caua-veiga/Projeto-Integrador/Relatorio/guiaoProjIntegrador.pptx

Guião para a apresentação

- Introduzir o tema
- Overview do sistema final

- Planeamento do projeto
  - Filosofia bottom-up pois não tinhamos a estrutura disponível

- Modulo: Sensor MPU 6050
  - Razões para escolha do modelo
  - Leitura I2C
  - Data fusion: acelerometro + giroscopio, filtro complementar

- Modulo: ESCs e motores sem escovas
  - Especificações do motor
  - Modo de funcionamento da ESC
  - Desvantgem ESP32: Conversão 3.3V->5.0V com OpAmps
  - Queima da ESP32
    - Separar grounds, adicionar 2ª fonte, passer para bidirecional
  - Calibração da ESC

Felipe

Cauã

## Slide 2

  - Algoritmo PID
    - Principio básico de funcionamento
    - Incremental: 1 output para 2 controladores, ±0.5δ
    - Modificações:
      - Limitar termo integral para evitar upwinding
      - Acionar o termo integral apenas perto da posição de equilíbrio

- WiFi
  - Comunicação via socket
  - Fluxograma

Felipe

Cauã

- Video: Demonstração do funcionamento
  - Comentar presença do atrito
  - Comentar efeito do desalinhamento lateral dos motores
