caua-veiga/Projeto-Integrador/APRESENTAÇÃO_v2.pptx

## Controlo PID drone 1-dimensão

Cauã Veiga & Felipe Coutinho

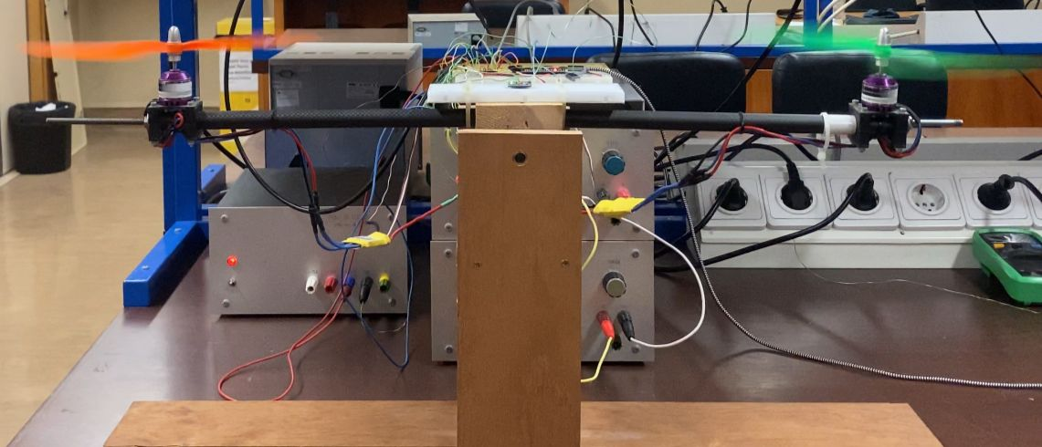
[picture p1: figure]

## Slide 2

Diagrama Circuito Final

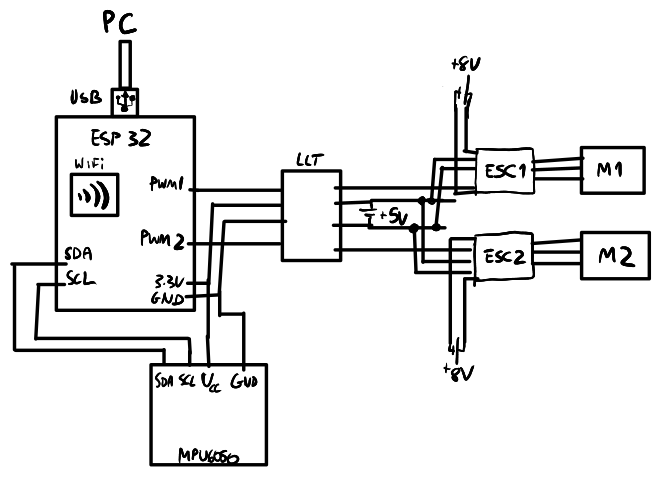
[picture p2: figure]

## Sensor MPU-6050

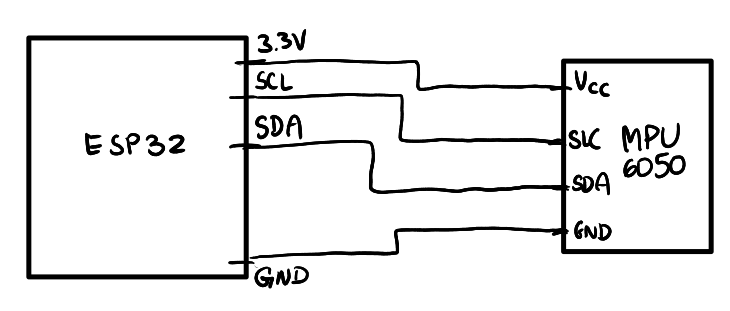
[picture p3: figure]
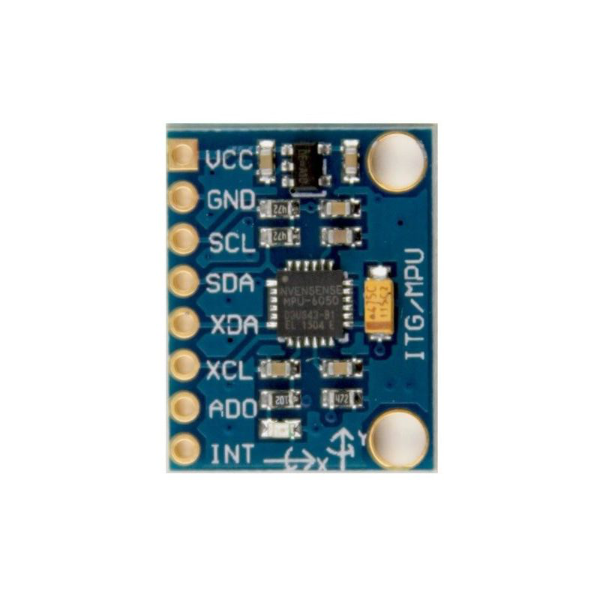
[picture p4: figure]

http://wiki.sunfounder.cc/index.php?title=MPU6050_Module

## Sensor MPU-6050

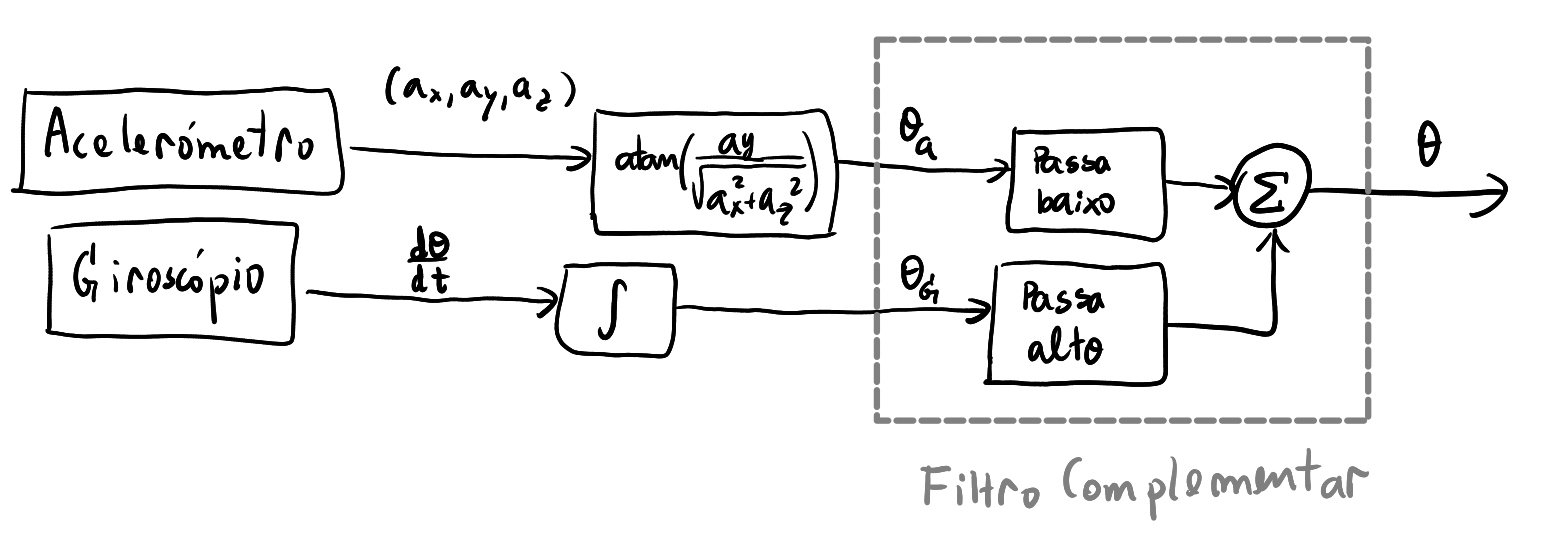
[picture p5: figure]

## Motor Sem Escovas

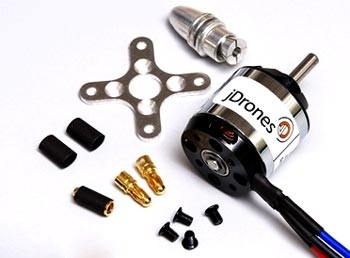
[picture p6: figure]

https://www.buildyourowndrone.co.uk/850kv-motor-ac2830-358

Fonte: 8V
Corrente: 1A

## Slide 6

Electronic Speed Control

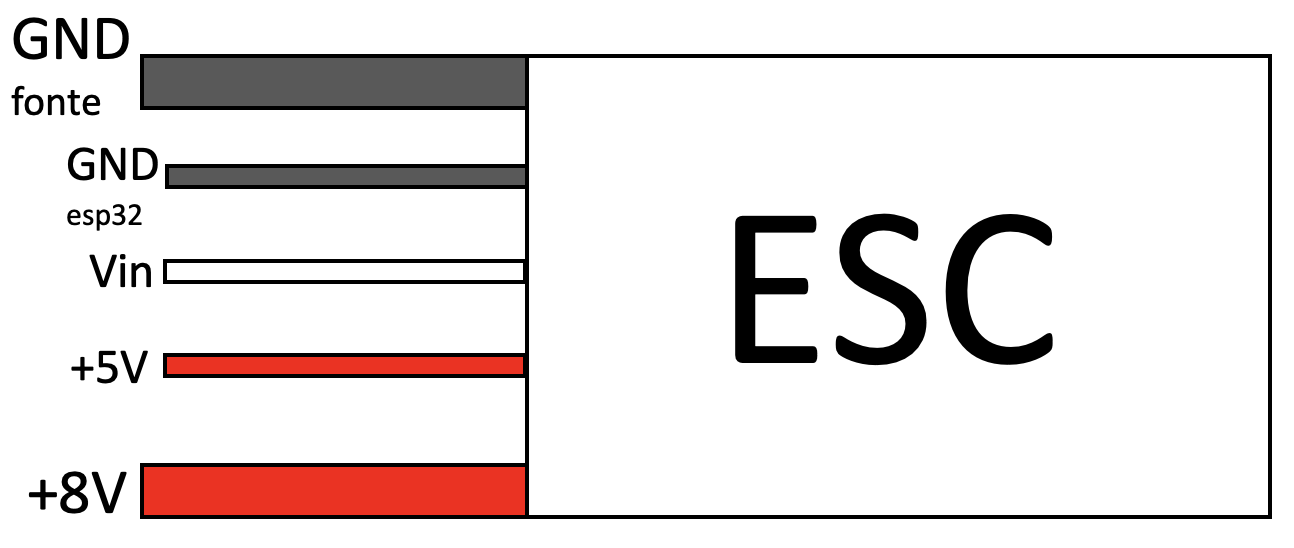
[picture p7: figure]

## Slide 7

Pulse Width Modulation

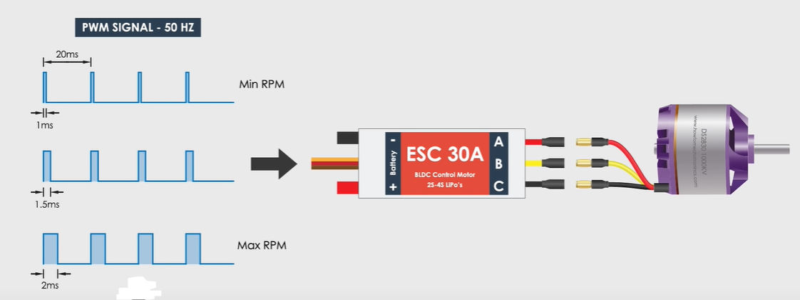
[picture p8: figure]

“How Brushless Motor and ESC Work and How To Control them using Arduino” https://www.youtube.com/watch?v=uOQk8SJso6Q

## Slide 8

Conversão 3.3V -> 5V

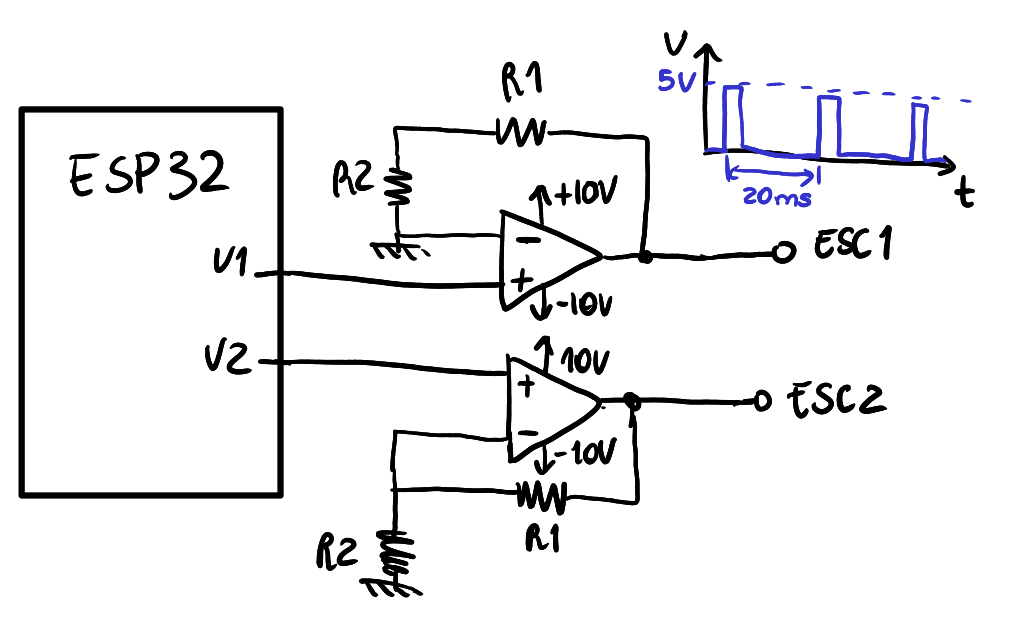
[picture p9: figure]

## Slide 9

Bidirecional 3.3V5V

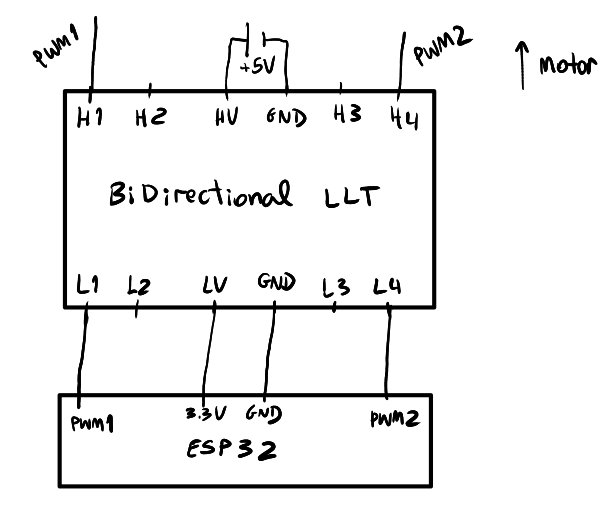
[picture p10: figure]

## Slide 10

Controlador PID

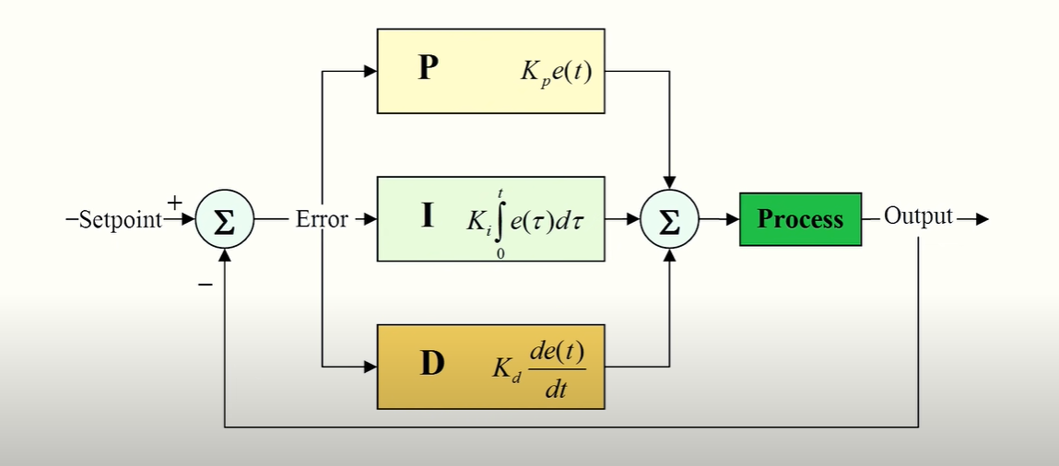
[picture p11: figure]

https://blog.kakaocdn.net/dn/Nk0zF/btqCWdW5LfQ/AUKAtpamO2Ky9Bko9YrWg1/img.png

## Slide 11

Controlador PID

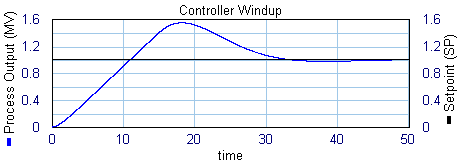
[picture p12: figure]

https://www.20sim.com/webhelp/library_signal_control_pid_control_antiwindup.php

## Slide 12

Comunicação WiFi

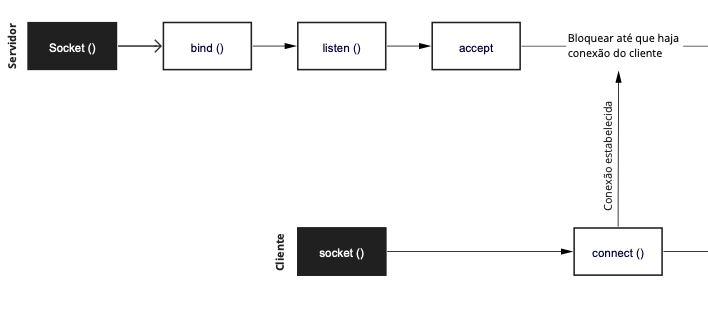
[picture p13: figure]

## Slide 13

Comunicação WiFi

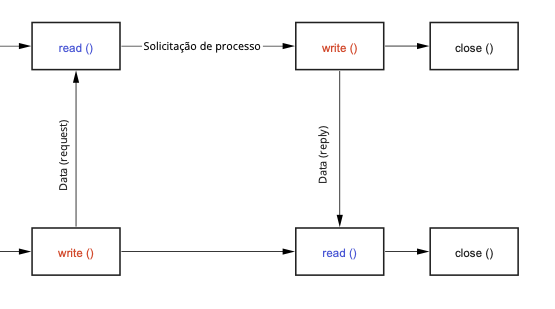
[picture p14: figure]

## Slide 14

Sistema Final

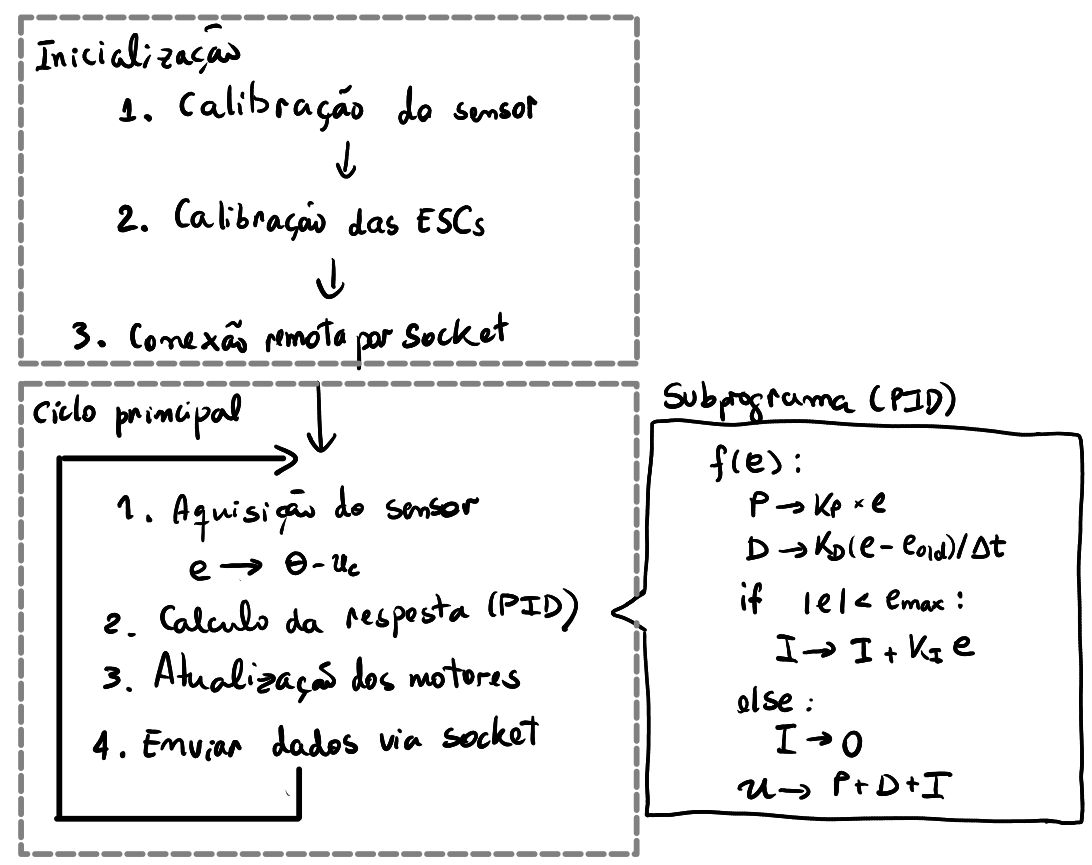
[picture p15: figure]

## Slide 15

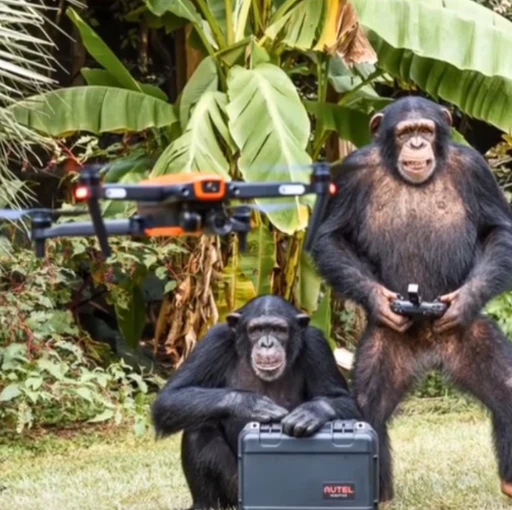
[picture p16: figure]

Demonstração
