caua-veiga/Projeto-Integrador/APRESENTAÇÃO.pptx

## Controlo PID drone 1-dimensão

Cauã Veiga & Felipe Coutinho

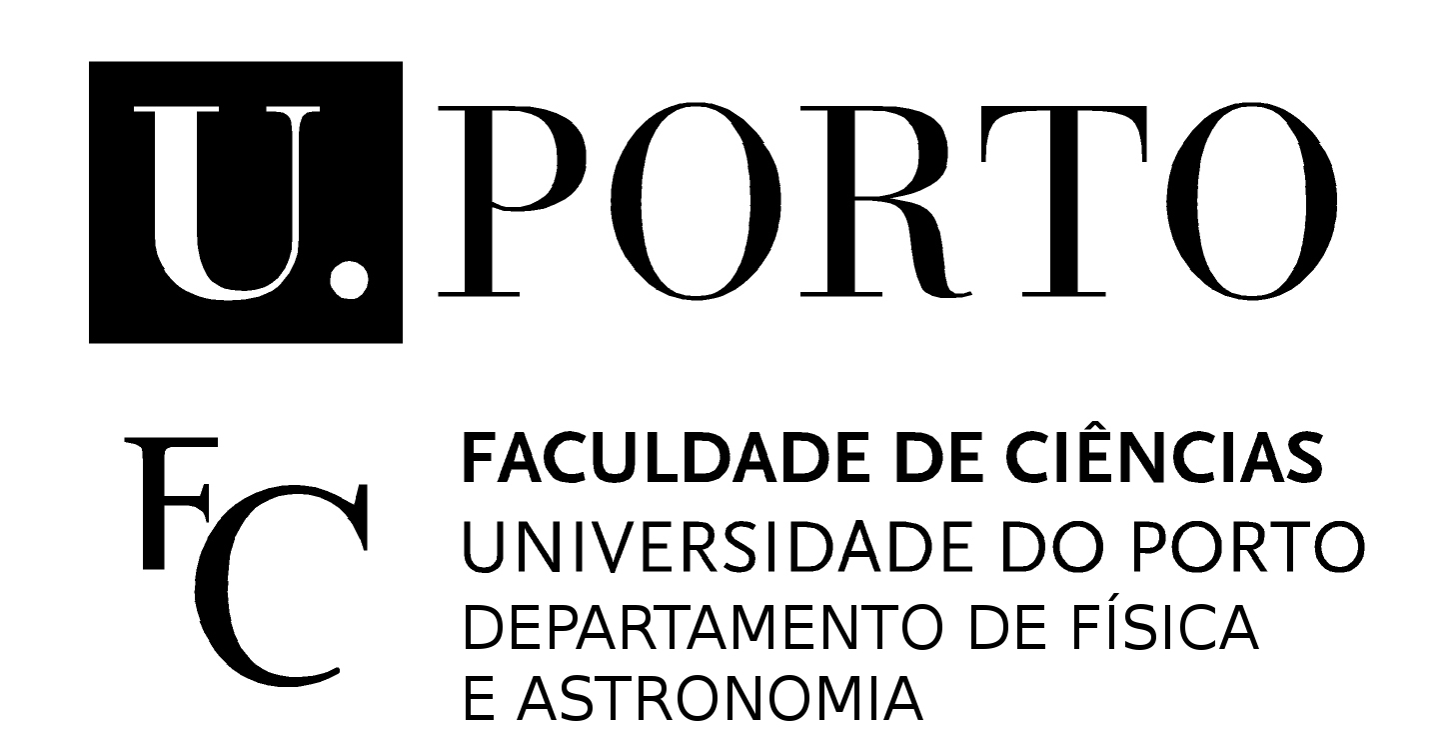
[picture p25: figure]
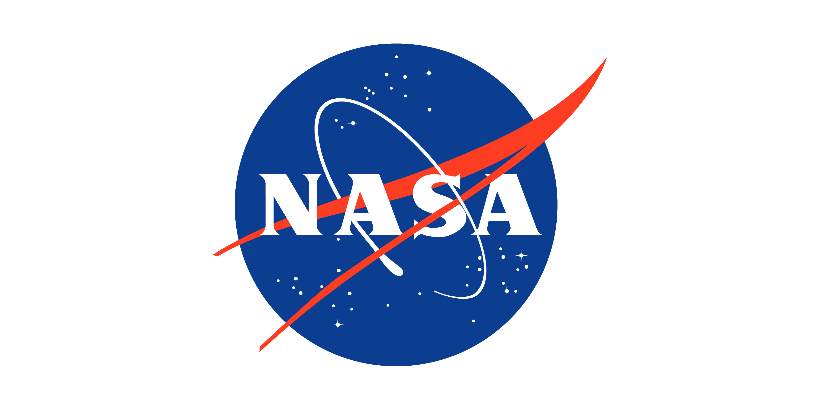
[picture p26: figure]
Symbols of NASA | NASA

## Slide 2

Diagrama Circuito Final


## Sensor MPU-6050


## Sensor MPU-6050


## Motor Sem Escovas


Fonte: 8V
Corrente: 1A

## Slide 6

Electronic Speed Control


## Slide 7

Pulse Width Modulation


## Slide 8

Conversão 3.3V -> 5V


## Slide 9

Bidirecional 3.3V5V


## Slide 10

Controlador PID


## Slide 11

Controlador PID


## Slide 12

Comunicação WiFi


## Slide 13

Comunicação WiFi


## Slide 14

Sistema Final


## Slide 15


Demonstração
