caua-veiga/Projeto-Integrador/Relatorio/imagens/exemplo_leituraSensor.PNG

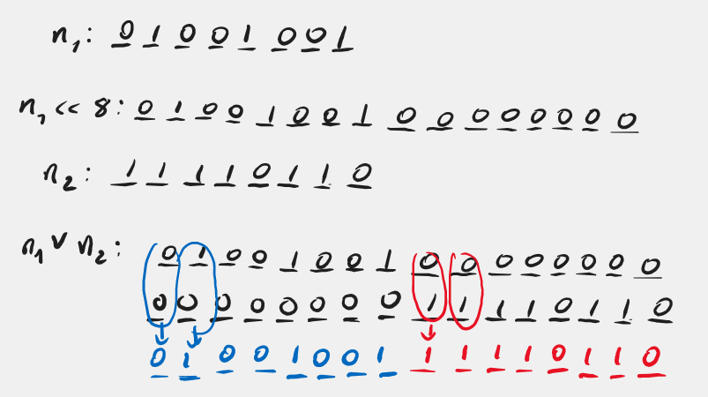
Relatorio/imagens/exemplo_leituraSensor.PNG
