caua-veiga/Projeto-Integrador/Relatorio/imagens/mpu6050_accel_registers.PNG

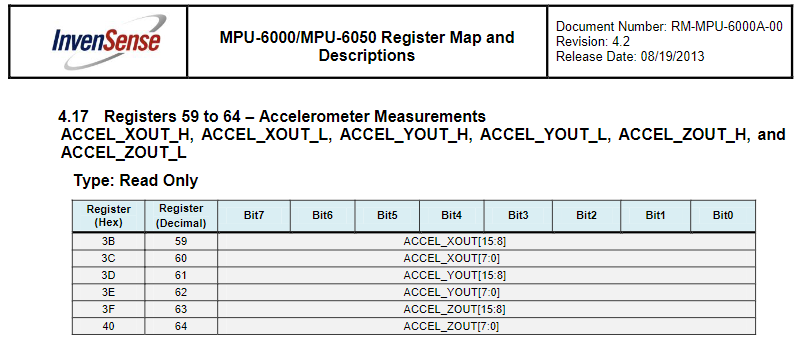
Relatorio/imagens/mpu6050_accel_registers.PNG
