caua-veiga/Projeto-Integrador/Relatorio/imagens/mpu6050_gyro_registers.PNG

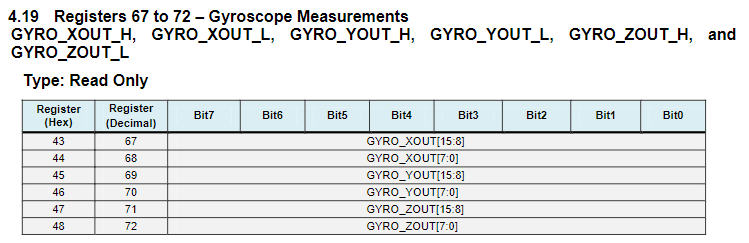
Relatorio/imagens/mpu6050_gyro_registers.PNG
