caua-veiga/Projeto-Integrador/Relatorio/PIDDiagramaDeBlocos.PNG

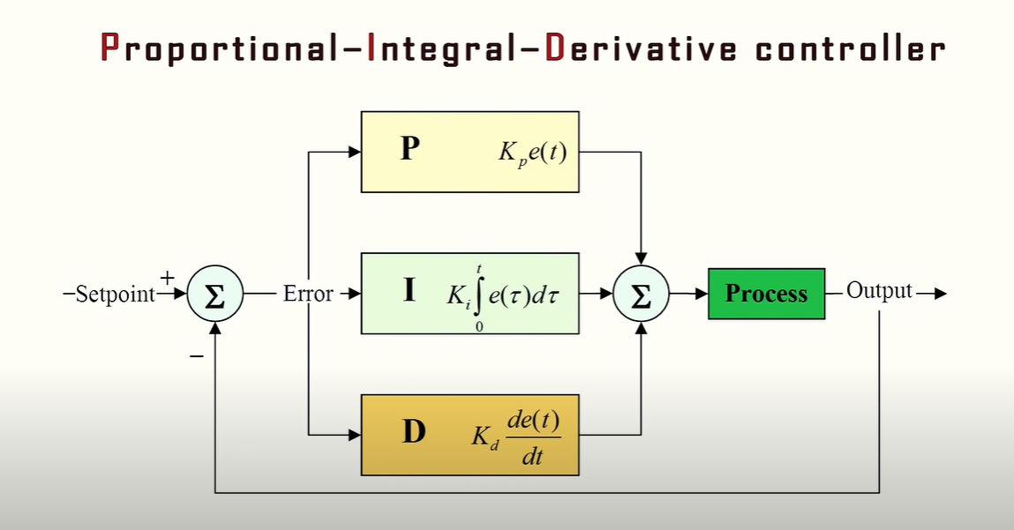
Relatorio/PIDDiagramaDeBlocos.PNG
