caua-veiga/Projeto-Integrador/Relatorio/Wi-Fi.png

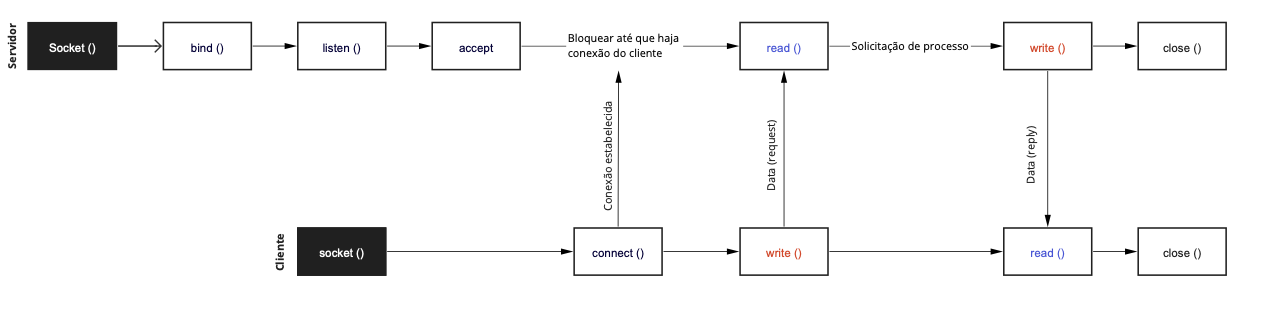
Relatorio/Wi-Fi.png
