caua-veiga/Projeto-Integrador/Logbook/Componentes/comp_motor850Kv.md

https://www.buildyourowndrone.co.uk/850kv-motor-ac2830-358

850Kv Brushless Motor for Multi Rotor QuadCopters, HexaCopters & OctoCopters

This is the ArduCopter multi rotor 850Kv motor which is used by most of the ArduCopter multi rotor developers. It's very reliable and even though it's a smaller motor than its counterpart the 880Kv, it delivers a very good level of thrust with the matched 10x45 propellers.

This 850Kv motor can be bought in a matched and ready to fly kit too, either in a Quadcopter or Hexacopter multi rotor configurations

Motor features:

Size: 28 x 30 mm.

Shaft: 3.17mm.

RPM/V: 850 Kv.

Prop: 10x45.

Battery: 2-4 S LiPo.

Weight: 62gr.

Cables: 35cm / 18 AWG with non soldered bullets.

Tested thrust:

Power out put from ESC, 3S LiPo, 10x45 Propeller:

25%	50%	75%	100%
Amp
Wattage
Thrust	
1 A
11W
170gr

3.4 A
38W
433gr

9 A
100W
855gr

12.2 A
135W
1095gr

Table to get battery voltage
https://blog.ampow.com/lipo-voltage-chart/
