caua-veiga/Projeto-Integrador/Logbook/Componentes/comp_880Kv.md

https://www.buildyourowndrone.co.uk/880kv-motor-ac2836-358

880Kv Brushless Motor for Multi Rotor QuadCopters, HexaCopters & OctoCopters

This is the ArduCopter 880Kv motor which is used for heavier payloads on quadcopters and hexacopter. It's a very reliable motor and is bigger than its counterpart the 850Kv, it delivers a very high level of thrust with the matched 12x45 propellers.  

This 880Kv motor can be bought in a matched and ready to fly kit too, either in a Quadcopter or Hexacopter configurations

This motor is designed for 12x45 Propellers.

Motor features:

Size: 28 x 36 mm.

Shaft: 4mm.

RPM/V: 880 Kv.

Prop: 12x45.

Battery: 2-4 S LiPo.

Weight: 72gr.

Cables: 35cm/18 AWG with bullets (non soldered).

Tested thrust:

Power out put from ESC, 3S LiPo, 12x45 Propeller:

25%

50%

75%

100%

Amp
Wattage
Thrust

1.5 A
17.5W
230gr

6.1 A
70W
650gr

14.2 A
160W
1290gr

20A A
210W
1380gr
