caua-veiga/Projeto-Integrador/Logbook/Componentes/jdrones_wayback.md

https://web.archive.org/web/20110924103158/http://store.jdrones.com/product_p/achxkit1.htm
