caua-veiga/Projeto-Integrador/Logbook/References/Sensor/sourceCode_mpu6050_autocalibration.md

Este código implementa uma rotina de autocalibração para o MPU6050 para Arduino

Para perceber melhor, convém ver o paper sobre isso no diretório References

https://wired.chillibasket.com/2015/01/calibrating-mpu6050/
