caua-veiga/Projeto-Integrador/Logbook/References/References.md

Drone-Deep-Reinforcement-Learning - https://github.com/Kazimbalti/Drone-Deep-Reinforcement-Learning-

Python library for servos - https://docs.micropython.org/en/latest/library/pyb.html
