caua-veiga/Projeto-Integrador/Logbook/ESP32_temp/ESP32.md

# RASCUNHO GUARDAR LINKS    

Podemos ver as placas suportadas pelo tensorflow lite em:
https://www.tensorflow.org/lite/microcontrollers

Talvez fosse boa ideia pedir ao professor um ESP32 pois já teremos experiência de EDM e sabemos que suporta python fácilmente. 

Para além disso, o IMU MPU-6050: https://invensense.tdk.com/products/motion-tracking/6-axis/mpu-6050/

é também fácilmente suportado pelo ESP32: https://randomnerdtutorials.com/esp32-mpu-6050-accelerometer-gyroscope-arduino/

Exemplo de tensorflow lite no esp32: https://blog.tensorflow.org/2020/08/announcing-tensorflow-lite-micro-esp32.html

### Deep Reinforcement Learning on ESP32
https://www.hackster.io/aslamahrahiman/deep-reinforcement-learning-on-esp32-843928

https://github.com/aslamahrahman/Policy-Gradient-Network-Arduino
