caua-veiga/Projeto-Integrador/Logbook/Week_Progress/Week1.md

# Done

In the first week as a prepation we planned the main scope of our project. During the class we occupied ourselves by identifying the material given to us, we gathered some documentation about the components (Componentes directory) and properly disassembled the drone so that we can continue our work next week. 

## 1. Identified Components
1. 850Kv Brushless Motor - https://www.buildyourowndrone.co.uk/850kv-motor-ac2830-358

2. jDrones 20 Amp ESC AC20-1.0 - https://www.buildyourowndrone.co.uk/arducopter-esc-20-amp
