caua-veiga/Projeto-Integrador/Logbook/References/Sensor/sourceCode_mpu6050light_arduino.md

Link para o source code do pacote MPU6050_light feito para Arduino

Este pacote implmeneta uma API para acessar as informações do sensor

https://github.com/rfetick/MPU6050_light/blob/master/src/MPU6050_light.cpp
