caua-veiga/Projeto-Integrador/Final Code/motor.py

import time
from machine import Pin, PWM
import uasyncio


class Motor():

    def __init__(self,PIN):
        self.pin = PIN
        self.pwm = PWM(Pin(PIN)) # Defining the GPIO Pin that will output our PWM signal
        self.pwm.freq(50) # The frequency of our PWM will always be 50Hz
        self.pwm.duty(int(1/20*1023))


    def writePWM(self, inc):
        # print("attempting write" + "  " + str(inc), end="\n")
        # Use only with the PID
        # This is meant to update the current duty value with an increment
        min_duty_allowed = 0.
        max_duty_allowed = 0.7
        curr_duty = 20*self.pwm.duty()/1023 - 1
        new_duty = curr_duty + inc
        # print("increment" + "  " + str(new_duty), end="\n")
        new_duty = 0 if new_duty < min_duty_allowed else new_duty
        new_duty = max_duty_allowed if new_duty > max_duty_allowed else new_duty
        x = (new_duty + 1)/20
        self.pwm.duty(int(x*1023))

    def setPWM(self, new_duty):
        # Use with calibration
        # This is meant to set a new absolute duty value
        if new_duty > 1:
            new_duty = 1
        if new_duty < 0:
            new_duty = 0

        x = (new_duty + 1)/20
        self.pwm.duty(int(x*1023))
        print(f'Calib. Motor {self.pin}:  {int(x*1023)}',end='\n')

    def deinit(self):
        self.pwm.deinit()
