caua-veiga/Projeto-Integrador/Logbook/CODES/esc_calib_esp32/esc_pwm_params.txt

Freq = 50Hz
Period = 20ms
Lowest Negative Duty = 5%
Greatest Negative Duty = 10%
Pico-Pico = 4.8V
