caua-veiga/Projeto-Integrador/(commit log)

2022-04-26 Files To Track Our Progress
2022-04-26 1 - Control the motor with Arduino
2022-04-26 ignore and joint scketch
2022-04-27 Arduino IDE + python tutorial lin
2022-04-27 MPU6050 IMU sensor documentation
2022-04-27 ESC Calibration
2022-04-27 Read the data from the accelerometer
2022-04-27 Read the data from the gyroscope
2022-04-28 Update Week2.md
    Added considerations about how to integrate Python with Arduino
2022-04-28 overview of sensor data processing
    description of required sensors and of complementary filtering technique
2022-04-28 added reference on the complementary filter
2022-04-28 ESP32 Rascunho
2022-04-28 DPL Esp32
2022-04-29 ESC Calibration arduino uno
2022-05-05 Lib for Servos
2022-05-13 esc pwm params
    [esc_pwm_params.txt]
2022-05-13 Sensor Config alfa
2022-05-15 a lot of reorganization sensor code done a lot of references added about the sensor
2022-05-18 att sensor
2022-05-20 Calirbação dos motores com ESP32
2022-05-21 added the pid code, which has not been tested yet
2022-05-24 PID Class print method
2022-05-24 Created Class to Calibrate The Esc
2022-05-24 PID CHECKPOINT TESTED
2022-05-26 Códigos Sensor MPU e PID atualizados -- Terça-Feira
2022-05-26 Exemplo comunicacao TCP e tentativa de integracao no codigo do sensor+pid (ainda nao funciona)
2022-05-29 Classe Motor Deinit
2022-05-31 relatorio - sensor
2022-06-02 relatorio PID
2022-06-04 fixing the esc calibration
    [client.py, main.py, motor.py, mpu6050.py, pid.py]
2022-06-15 Calibração sensor + pwm funcionando
2022-06-15 PID BAEARLLY WORKING
2022-06-15 PID WORKING
2022-06-18 Troca palavras na introdução; add to-do nos motores; Comecei a falar sobre o wifi
2022-06-28 imagens para powerpoint
    ta uma bagunça
2022-06-28 brushless motor
2022-06-28 esc + pwm example
2022-06-28 Add files via upload
    PowerPoint Presentation
2022-06-28 guiao para apresentacao
